Rocket-UTFPR/Foguete_1km_2026/(list of files, cad)

Other CAD files:
Hardware/Telemetria/telemetria.f3d
