Rocket-UTFPR/Foguete_1km_2026/Hardware/Telemetria/telemetria.brd

## EAGLE design Hardware/Telemetria/telemetria.brd (2026-07-31)

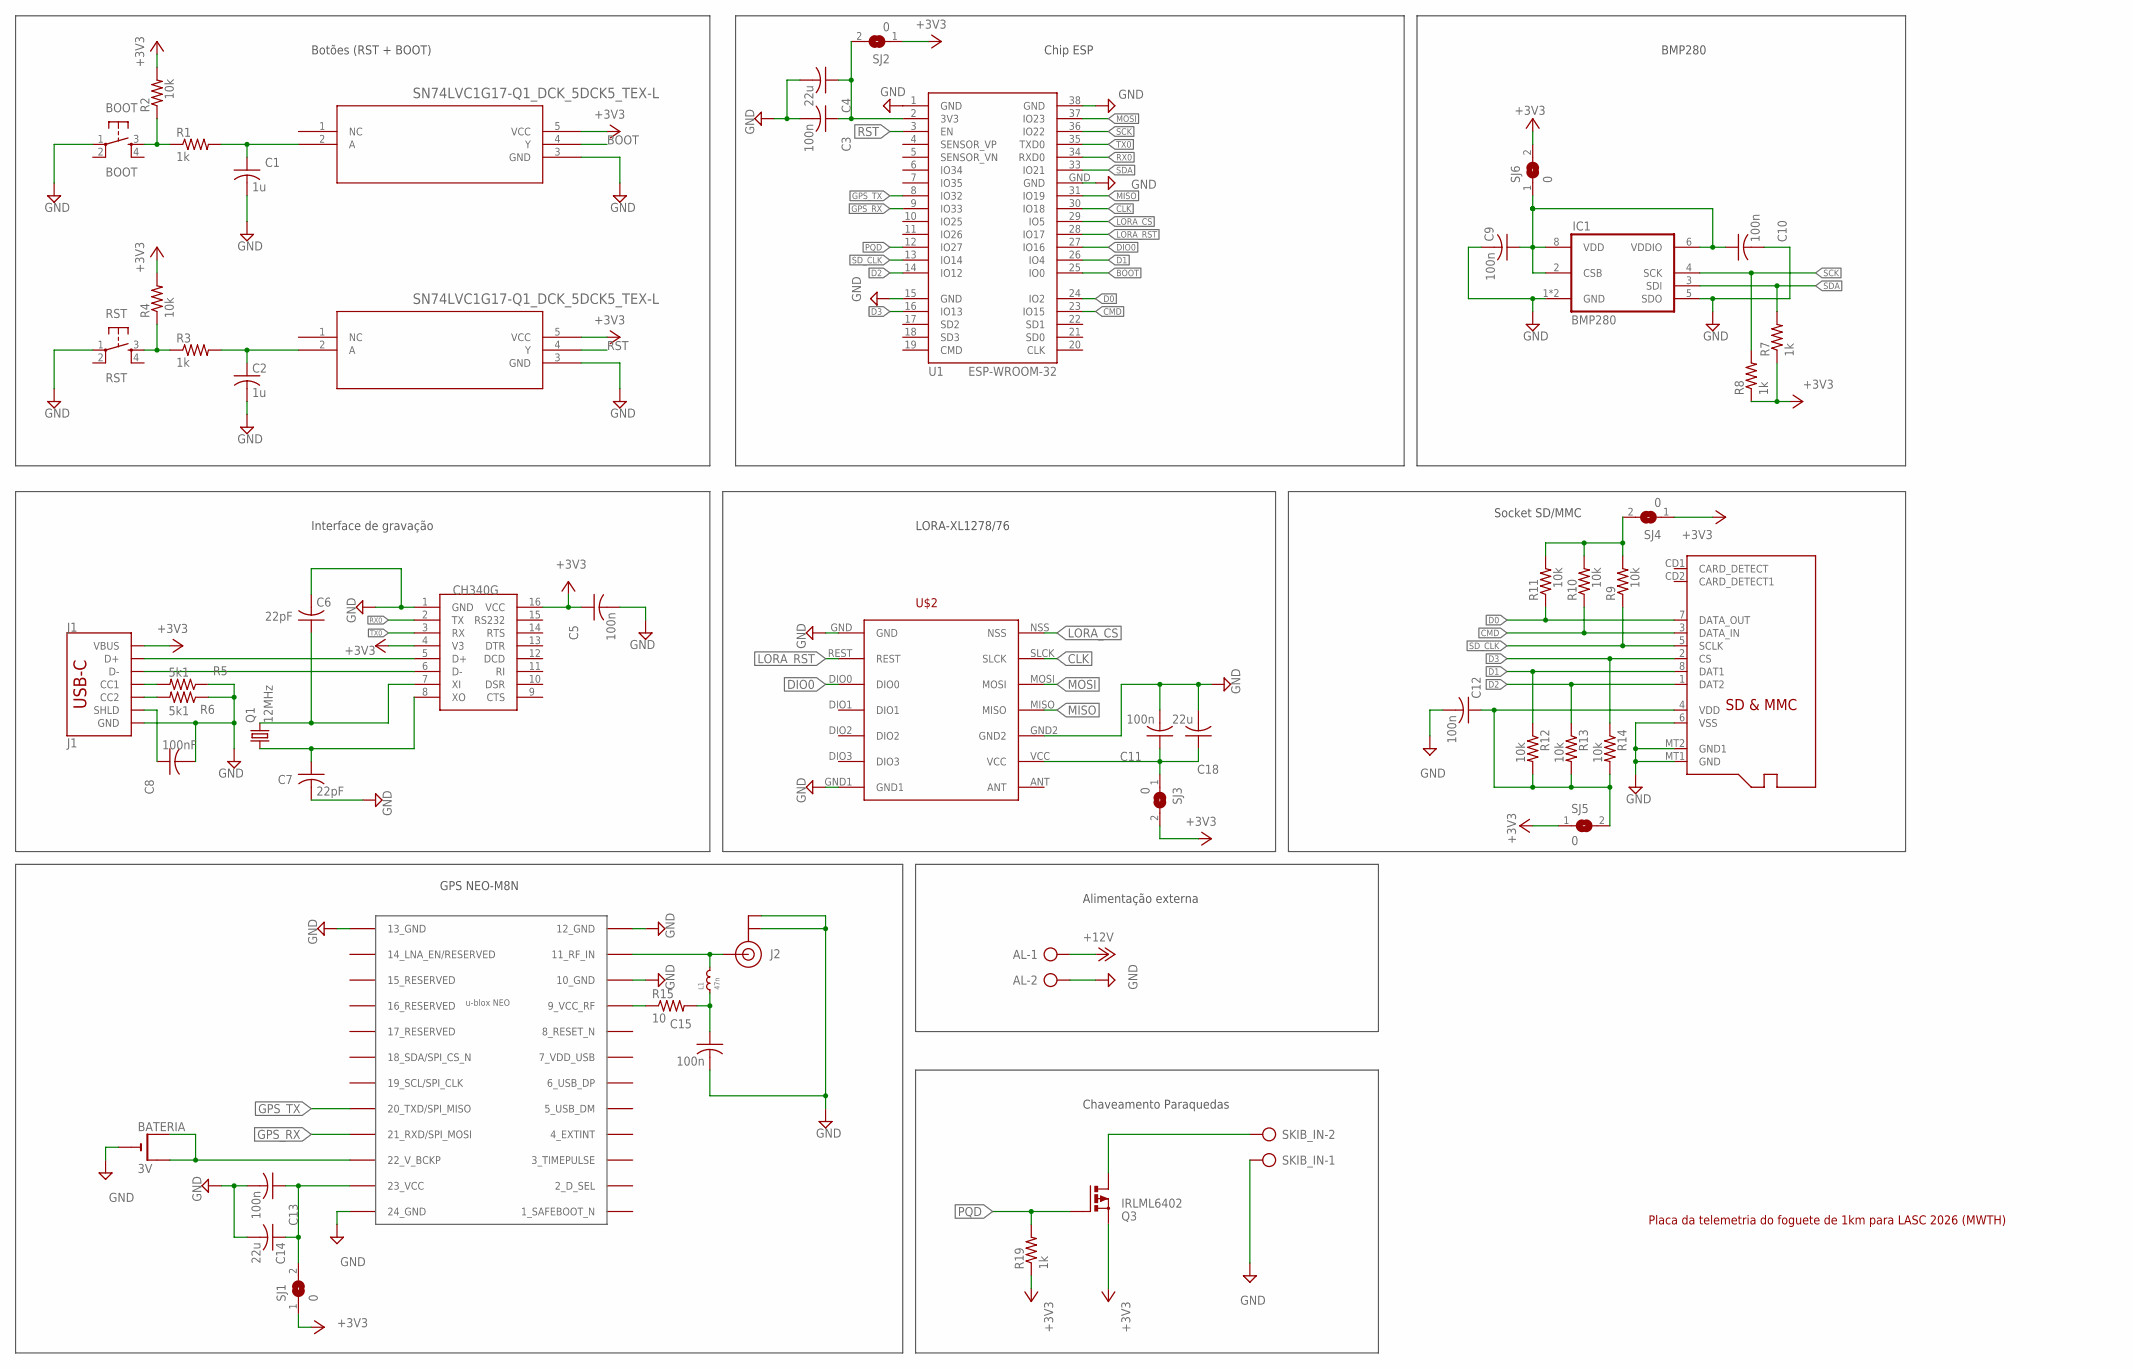
[picture p1: schematic telemetria.sch, sheet 1]

Parts:
AL: AL; AK500/2-H
BATERIA: 3V; CR2032-THRU
BOOT: BOOT; TACTILE-PTH
C1, C2: 1u; C3216
C3, C5, C9, C10, C11, C12, C13, C15: 100n; C3216
C4, C14, C18: 22u; C3216
C6, C7: 22pF; C3216
C8: 100nF; C3216
IC1: BMP280
J1: J1; USB-C-16P-2LAYER-PADS
J2: U.FL
L1: 47n; 0402
Q1: 12MHz; HC49/S
Q3: IRLML6402; SOT-23
R1, R3, R7, R8, R19: 1k; R1206
R2, R4, R9, R10, R11, R12, R13, R14: 10k; R1206
R5, R6: 5k1; R1206
R15: 10; R1206
RST: RST; TACTILE-PTH
SCHMITT-1, SCHMITT-2: SN74LVC1G17-Q1_DCK_5DCK5_TEX-L; DCK5_TEX-L
SJ1, SJ2, SJ3, SJ4, SJ5, SJ6: 0; SJ
SKIB_IN: SKIB; AK500/2-H
U1: ESP-WROOM-32
U$1: CH340G; SOIC16
U$2: LORA; LORAXL1276/78
U$3: MICROSD
U$4: NEO-M8

Connections:
3V3: R9.2, R10.2, R11.2, SJ4.2
3V3_GPS: C13.1, C14.1, SJ1.2, U$4.23 (23_VCC)
+3V3: C5.1, J1.VBUS1 (VBUS), J1.VBUS2 (VBUS), Q3.P2 (S), R2.2, R4.2, R7.1, R8.1, R19.1, SCHMITT-1.5 (VCC), SCHMITT-2.5 (VCC), SJ1.1, SJ2.1, SJ3.2, SJ4.1, SJ5.1, SJ6.2, U$1.4 (V3), U$1.16 (VCC); also elsewhere on the board
+12V: AL.1; also elsewhere on the board
BOOT: SCHMITT-1.4 (Y), U1.25 (IO0)
CLK: U1.30 (IO18), U$2.SLCK
CMD: R10.1, U1.23 (IO15), U$3.3 (DATA_IN)
D0: R11.1, U1.24 (IO2), U$3.7 (DATA_OUT)
D1: R12.1, U1.26 (IO4), U$3.8 (DAT1)
D2: R13.1, U1.14 (IO12), U$3.1 (DAT2)
D3: R14.1, U1.16 (IO13), U$3.2 (CS)
DIO0: U1.27 (IO16), U$2.DIO0
ESP_VCC: C3.1, C4.1, SJ2.2, U1.2 (3V3)
GND: AL.2, BOOT.1, C1.2, C2.2, C3.2, C4.2, C5.2, C6.2, C7.2, C8.2, C9.2, C10.2, C11.2, C12.2, C13.2, C14.2, C15.2, C18.2, IC1.1 (GND), IC1.5 (SDO), IC1.7 (GND), J1.GND, J1.GND2 (GND), J2.1 (GND), J2.2 (GND), R5.1, R6.1, RST.1, SCHMITT-1.3 (GND), SCHMITT-2.3 (GND), SKIB_IN.1, U1.1 (GND), U1.15 (GND), U1.38 (GND), U1.GND, U$1.1 (GND), U$2.GND, U$2.GND1, U$2.GND2, U$3.6 (VSS), U$3.MT1 (GND), U$3.MT2 (GND1), U$4.10 (10_GND), U$4.12 (12_GND), U$4.13 (13_GND); also elsewhere on the board
GPS_RX: U1.9 (IO33), U$4.21 (21_RXD/SPI_MOSI)
GPS_TX: U1.8 (IO32), U$4.20 (20_TXD/SPI_MISO)
LORA_CS: U1.29 (IO5), U$2.NSS
LORA_RST: U1.28 (IO17), U$2.REST
MISO: U1.31 (IO19), U$2.MISO
MOSI: U1.37 (IO23), U$2.MOSI
unnamed: BOOT.3, R1.1, R2.1
unnamed: C1.1, R1.2, SCHMITT-1.2 (A)
unnamed: R3.1, R4.1, RST.3
unnamed: C2.1, R3.2, SCHMITT-2.2 (A)
unnamed: C7.1, Q1.1, U$1.8 (XO)
unnamed: C6.1, Q1.2, U$1.7 (XI)
unnamed: C8.1, J1.SHLD1 (SHLD), J1.SHLD2 (SHLD), J1.SHLD3 (SHLD), J1.SHLD4 (SHLD)
unnamed: J1.A5 (CC1), R5.2
unnamed: J1.B5 (CC2), R6.2
unnamed: BATERIA.-, U$4.24 (24_GND)
unnamed: J2.FEED (SIGNAL), L1.2, U$4.11 (11_RF_IN)
unnamed: C15.1, L1.1, R15.2
unnamed: R15.1, U$4.9 (9_VCC_RF)
unnamed: BATERIA.+1 (+), BATERIA.+2 (+1), U$4.22 (22_V_BCKP)
unnamed: C11.1, C18.1, SJ3.1, U$2.VCC
unnamed: Q3.P3 (D), SKIB_IN.2
PQD: Q3.P1 (G), R19.2, U1.12 (IO27)
RST: SCHMITT-2.4 (Y), U1.3 (EN)
RX0: U1.34 (RXD0), U$1.2 (TX)
SCK: IC1.4 (SCK), R8.2, U1.36 (IO22)
SDA: IC1.3 (SDI), R7.2, U1.33 (IO21)
SD_CLK: R9.1, U1.13 (IO14), U$3.5 (SCLK)
SJ_3V3: C9.1, C10.1, IC1.2 (CSB), IC1.6 (VDDIO), IC1.8 (VDD), SJ6.1
TX0: U1.35 (TXD0), U$1.3 (RX)
USBD_N: J1.A7 (D-), J1.B7 (D-), U$1.6 (D-)
USBD_P: J1.A6 (D+), J1.B6 (D+), U$1.5 (D+)
VDD: C12.1, R12.2, R13.2, R14.2, SJ5.2, U$3.4 (VDD)

Notes on the sheet:
Botões (RST + BOOT)
Interface de gravação
Chip ESP
BMP280
LORA-XL1278/76
Socket SD/MMC
GPS NEO-M8N
Chaveamento Paraquedas
Alimentação externa
Placa da telemetria do foguete de 1km para LASC 2026 (MWTH)

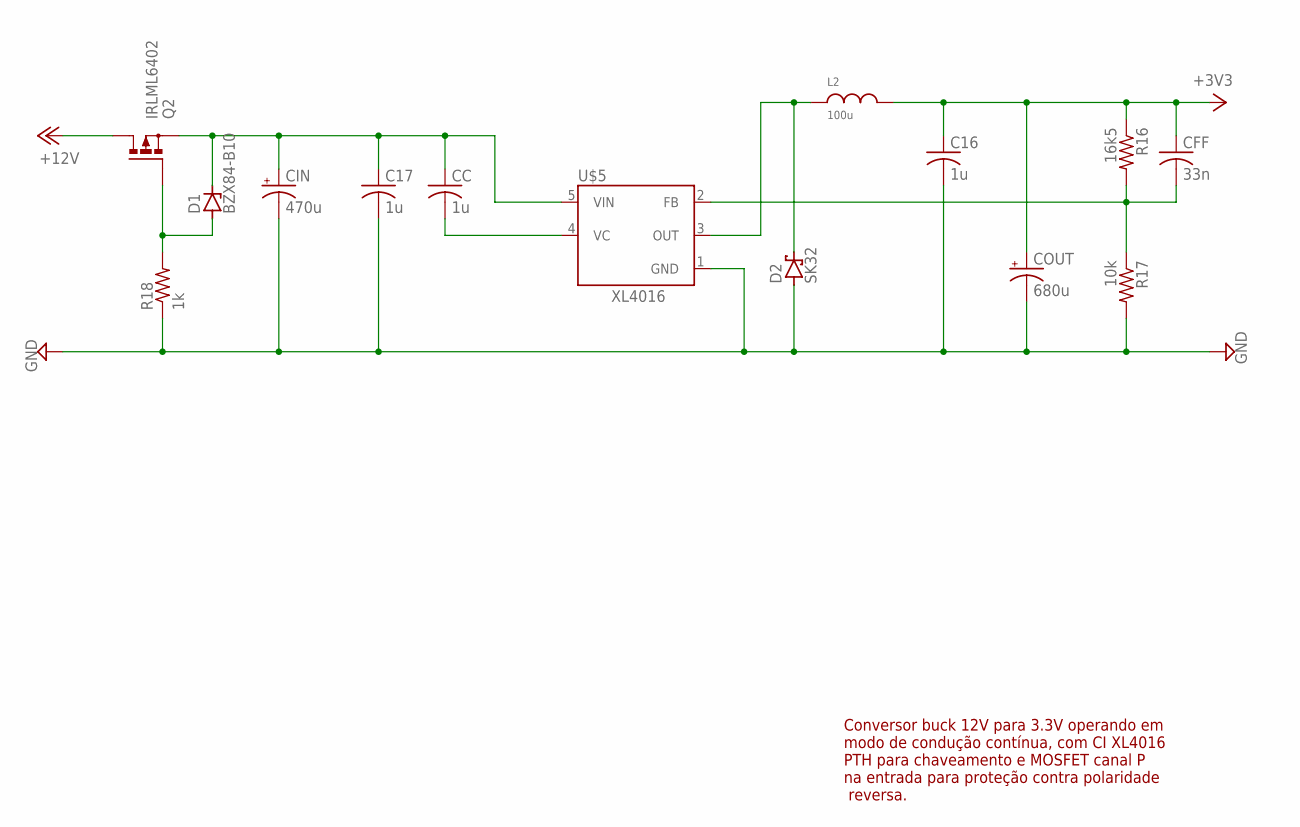
[picture p2: schematic telemetria.sch, sheet 2]

Parts:
C16, C17: 1u; C1206
CC: 1u; C1206
CFF: 33n; C1206
CIN: 470u; E3,5-8
COUT: 680u; E3,5-8
D1: BZX84-B10; SOT23
D2: SK32; SMC
L2: 100u; INDUTOR_125125
Q2: IRLML6402; SOT-23
R16: 16k5; R1206
R17: 10k; R1206
R18: 1k; M1206
U$5: XL4016; LM2576T2

Connections:
+3V2: C17.1, CC.1, CIN.+, D1.3 (C), Q2.P2 (S), U$5.5 (VIN)
+3V3: C16.1, CFF.1, COUT.+, L2.P$2, R16.1; also elsewhere on the board
+12V: Q2.P3 (D); also elsewhere on the board
BYPASS: CC.2, U$5.4 (VC)
FB: CFF.2, R16.2, R17.1, U$5.2 (FB)
GND: C16.2, C17.2, CIN.-, COUT.-, D2.A, R17.2, R18.1, U$5.1 (GND); also elsewhere on the board
unnamed: D1.1 (A), Q2.P1 (G), R18.2
SWOUT: D2.C, L2.P$1, U$5.3 (OUT)

Notes on the sheet:
Conversor buck 12V para 3.3V operando em modo de condução contínua, com CI XL4016 PTH para chaveamento e MOSFET canal P na entrada para proteção contra polaridade reversa.

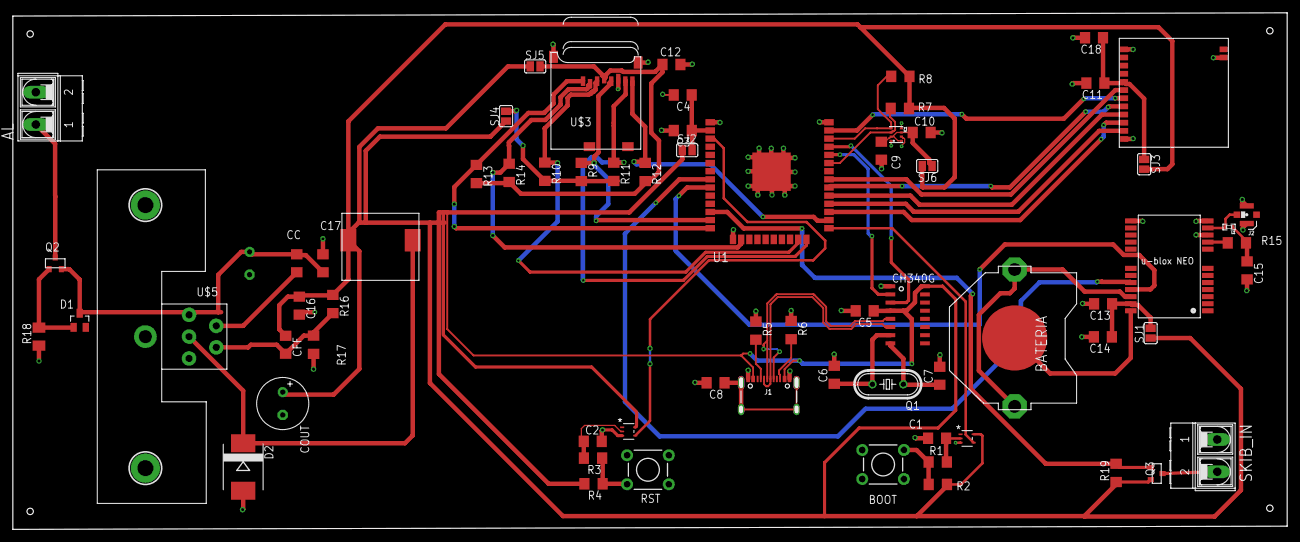
[picture p3: board telemetria.brd from above]

Board: 2 copper layers, 198.6 x 80.5 mm, 70 parts (1 on the bottom side), 52 nets.
