Rocket-UTFPR/Foguete_1km_2026/Hardware/Telemetria/buck_12-3v3_mcc.brd

## EAGLE design Hardware/Telemetria/buck_12-3v3_mcc.brd (2026-07-31)

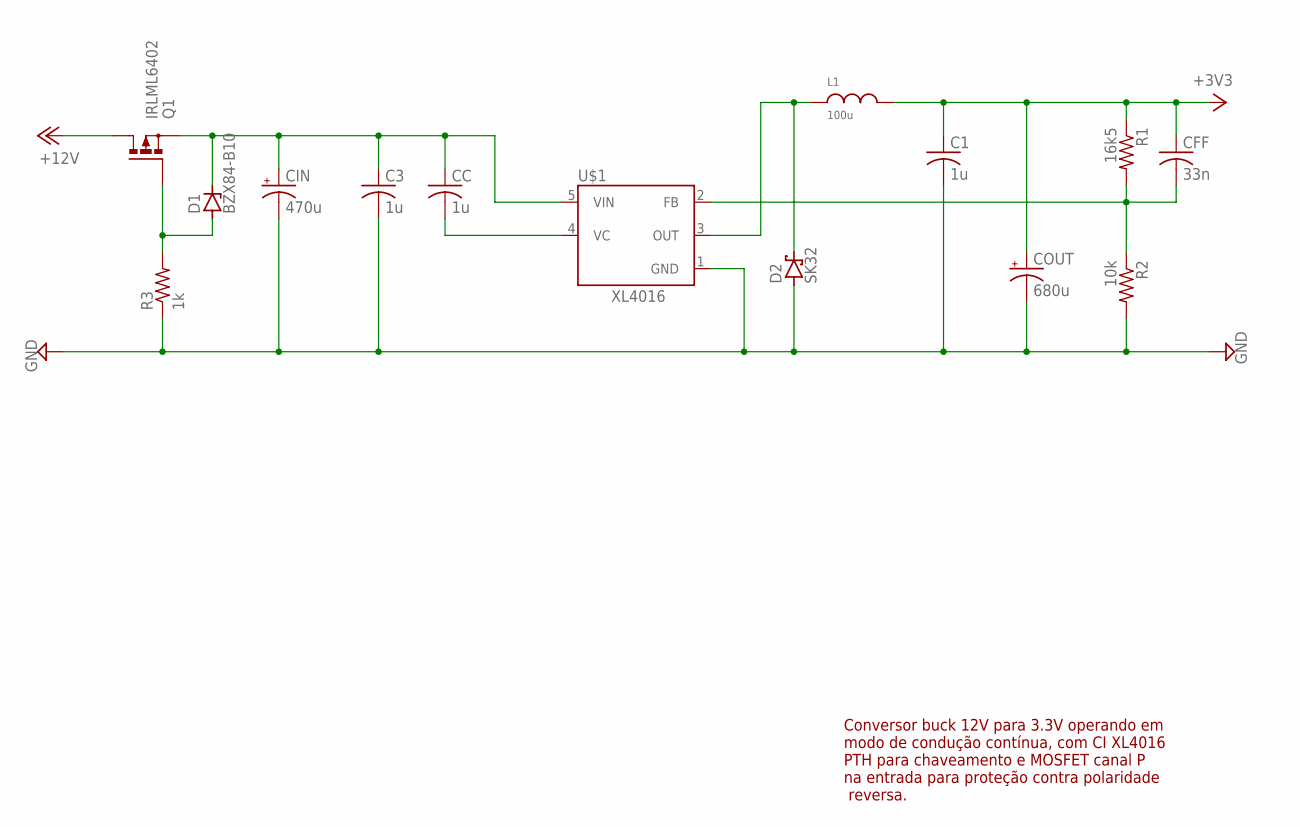
[picture p4: schematic buck_12-3v3_mcc.sch]

Parts:
C1, C3: 1u; C1206
CC: 1u; C1206
CFF: 33n; C1206
CIN: 470u; E3,5-8
COUT: 680u; E3,5-8
D1: BZX84-B10; SOT23
D2: SK32; SMC
L1: 100u; INDUTOR_125125
Q1: IRLML6402; SOT-23
R1: 16k5; R1206
R2: 10k; R1206
R3: 1k; M1206
U$1: XL4016; LM2576T2

Connections:
+3V2: C3.1, CC.1, CIN.+, D1.3 (C), Q1.P2 (S), U$1.5 (VIN)
+3V3: C1.1, CFF.1, COUT.+, L1.P$2, R1.1
+12V: Q1.P3 (D)
BYPASS: CC.2, U$1.4 (VC)
FB: CFF.2, R1.2, R2.1, U$1.2 (FB)
GND: C1.2, C3.2, CIN.-, COUT.-, D2.A, R2.2, R3.1, U$1.1 (GND)
unnamed: D1.1 (A), Q1.P1 (G), R3.2
SWOUT: D2.C, L1.P$1, U$1.3 (OUT)

Notes on the sheet:
Conversor buck 12V para 3.3V operando em modo de condução contínua, com CI XL4016 PTH para chaveamento e MOSFET canal P na entrada para proteção contra polaridade reversa.

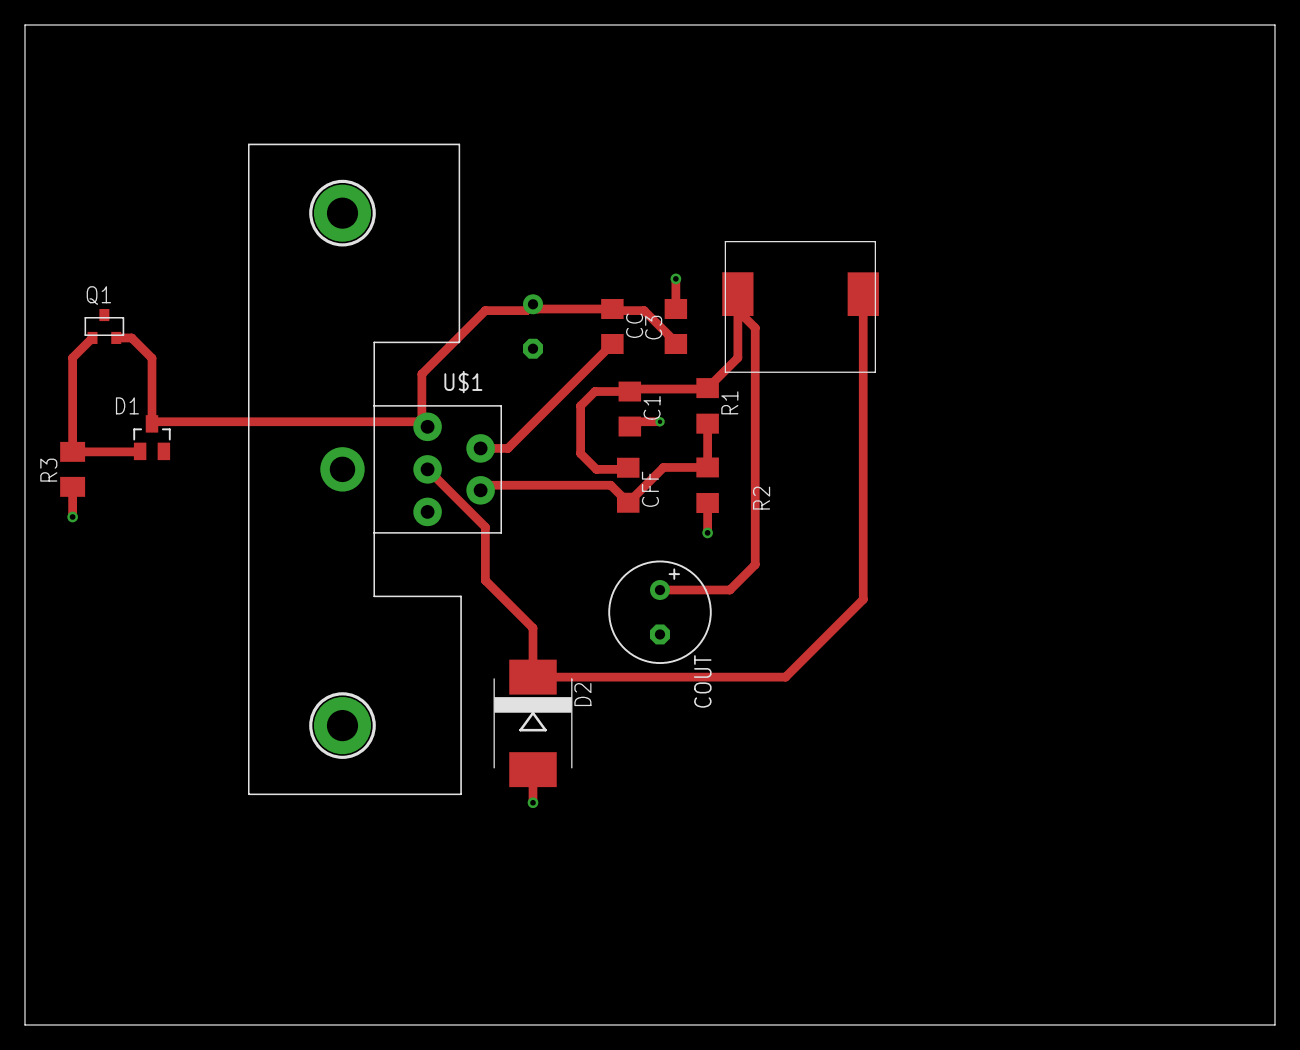
[picture p5: board buck_12-3v3_mcc.brd from above]

Board: 2 copper layers, 100.0 x 80.0 mm, 14 parts (1 on the bottom side), 7 nets.
