Rocket-UTFPR/Foguete_1km_2026/(commit log)

2026-04-30 Adição inicial de requisitos não-funcionais
    Adição dos requisitos não funcionais da placa de telemetria
2026-05-22 adicionado contador de pacotes perdidos
2026-05-25 log de debug, adaptado para SD SMD. Necessita testes
2026-05-28 commit de seguranca
2026-06-02 Medidas físicas adicionadas ao Read-me
    Added section for board measurements.
2026-06-12 inicio do standalone do ESP32
    [telemetria.brd, telemetria.sch]
2026-06-26 SD e LoRa no hardware
    [telemetria.brd, telemetria.sch]
2026-07-03 circuito de gps
    [telemetria.sch]
2026-07-09 Logica de acionamento do paraquedas alterada para utilizar enum de etapas de voo.
2026-07-15 esquematico finalizado
    [buck_12-3v3_mcc.brd, buck_12-3v3_mcc.sch, telemetria.brd, telemetria.sch]
2026-07-15 esquematico finalizado para revisao
    [telemetria.brd, telemetria.sch]
2026-07-17 placa finalizada
    [telemetria.brd, telemetria.f3d, telemetria.sch]
2026-08-19 Fix - Acionamento do Paraquedas
    Ainda no inicio
    [Telemetria.ino]
2026-08-21 Update - Ejeção, cartão SD
    termino da máquina de estado da Ejeção e implementação do arquivo.flush() no catão SD.
2026-08-23 Update do ENUM e Fix bug do vTaskDelay
    O ENUM da Etapas de Voo foi alterado para evitar conflito em futuras atualizações e melhorar a lógica de nomenclatura.
    Retirada o vTaskDelay de dentro do switch case para evitar bug de loop infinito sem delay, pois o código dava break e não entrava no vTaskDelay.
    [Telemetria.ino]
2026-08-25 Update volatile and close() do arquivo no setup
    Adição do volatile para as variaveis de altAtual e altAnterior, para evitar do compilador fazer ajustes de eficiencia que prejudiquem a gravação dos dados.
    Adição o arquivo.close() no setup.
2026-08-26 Fix - Casas decimais para latitude e longitude
    Aumento das casas decimais na transmissão da Latitude e Longitude do padrçao do comando String() que é 2 para 6.
    [Telemetria.ino]
2026-08-29 Update - Melhoramento da gravação do SD
    Realocação da gravação do SD na task de captação de dados para evitar atraso do Lora e da Fila. Testado e funcional, Discutir antes de subir pra placa FINAL.
