Rocket-UTFPR/Foguete_1km_2026/(notices)

Notices in the files:
parts and their libraries:
esp32: Creative Commons Attribution-ShareAlike 4.0 International
SparkFun-Retired: Licensing: Creative Commons ShareAlike 4.0 International - https://creativecommons.org/licenses/by-sa/4.0
SN74LVC1G17: COPYRIGHT: Copyright (C) 2026 Ultra Librarian. All rights reserved.
